WPI-SoftRobotics/SensorModule/TMAG PCB Layout.png

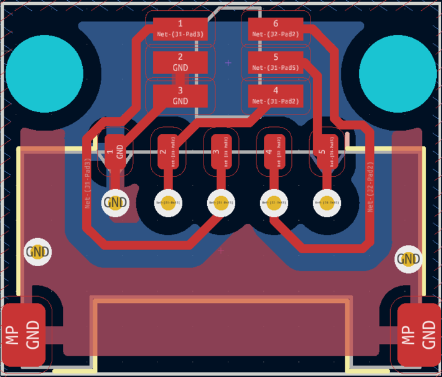
TMAG PCB Layout.png
