WPI-SoftRobotics/SensorModule/README.md

# SensorModule

this is the link to the google drive folder that contains that processed data papers and everything: https://drive.google.com/drive/folders/11iSitZ-SPJbaopdywDdSpedRKp8ysFOF?usp=share_link
