WPI-SoftRobotics/SensorModule/Past Iterations/Sensor/Sensor/TMAG Assembly.SLDASM

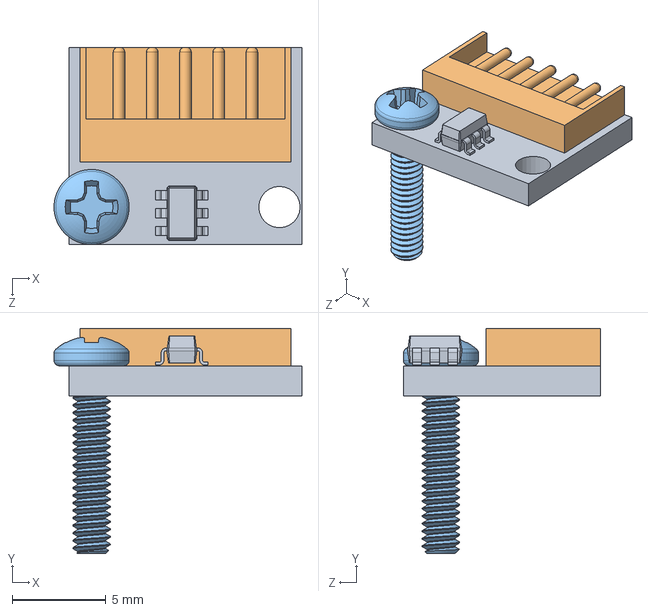
[picture p19: CAD file, 2023-05-02]
Past Iterations/Sensor/Sensor/TMAG Assembly.SLDASM
13.2 x 12.0 x 10.5 mm
