WPI-SoftRobotics/SensorModule/Past Iterations/Sensor/Sensor/Sensor Mount.SLDASM

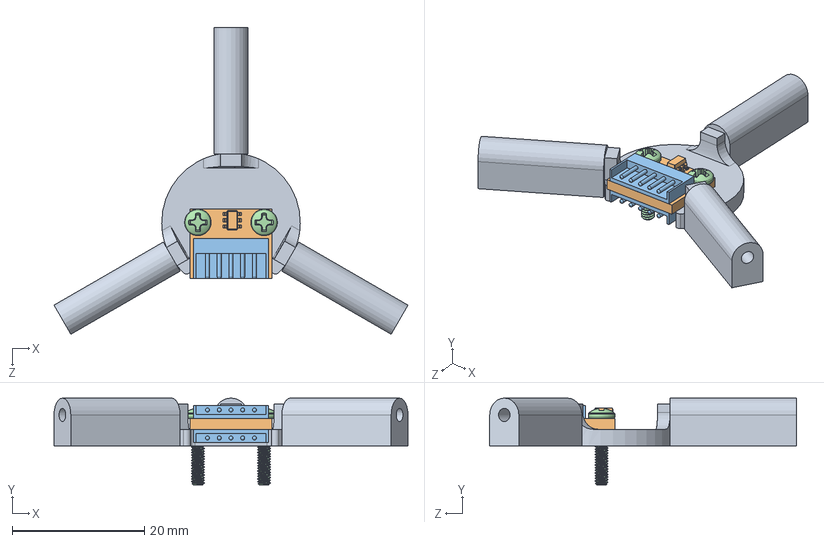
[picture p20: CAD file, 2023-05-02]
Past Iterations/Sensor/Sensor/Sensor Mount.SLDASM
53.4 x 13.1 x 46.3 mm
Sensor Mount
New TMAG5273
Pico Module x 2
96741A017_Brass Pan Head Phillips Screws x 2
