WPI-SoftRobotics/SensorModule/Past Iterations/Sensor testing/SensorTestRigAssem.SLDASM

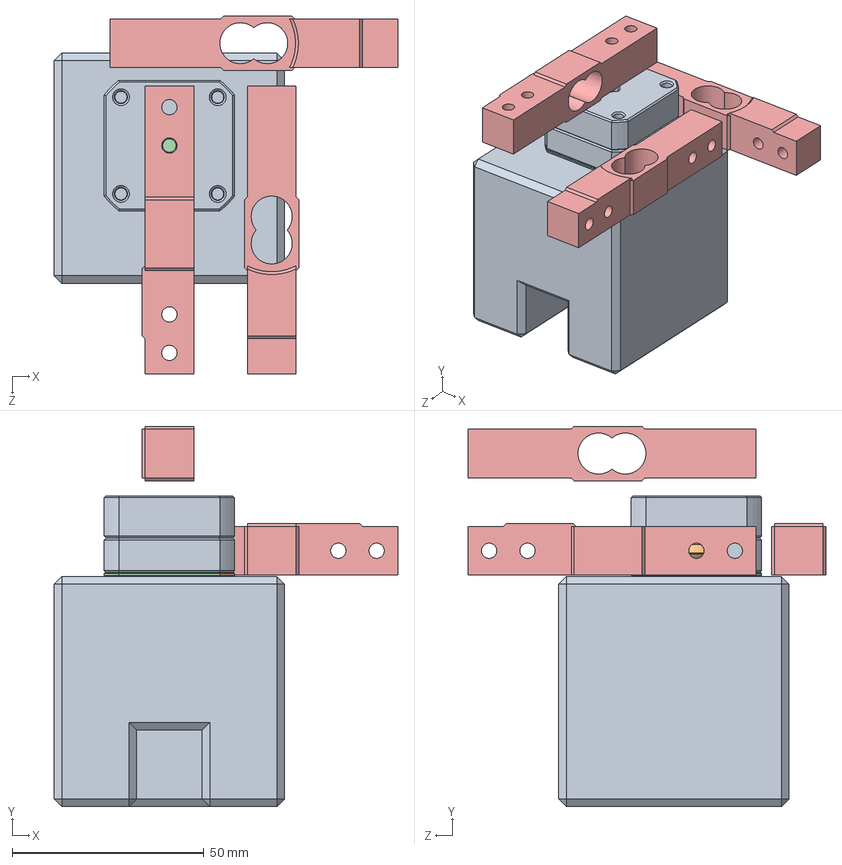
[picture p21: CAD file, 2023-05-02]
Past Iterations/Sensor testing/SensorTestRigAssem.SLDASM
89.5 x 99.1 x 93.2 mm
SensorMount
BellowsV2
ConeV2
FlatV2
LoadCell x 3
Pole
