WPI-SoftRobotics/SensorModule/Past Iterations/Sensor testing/SensorMountTopZ.STL

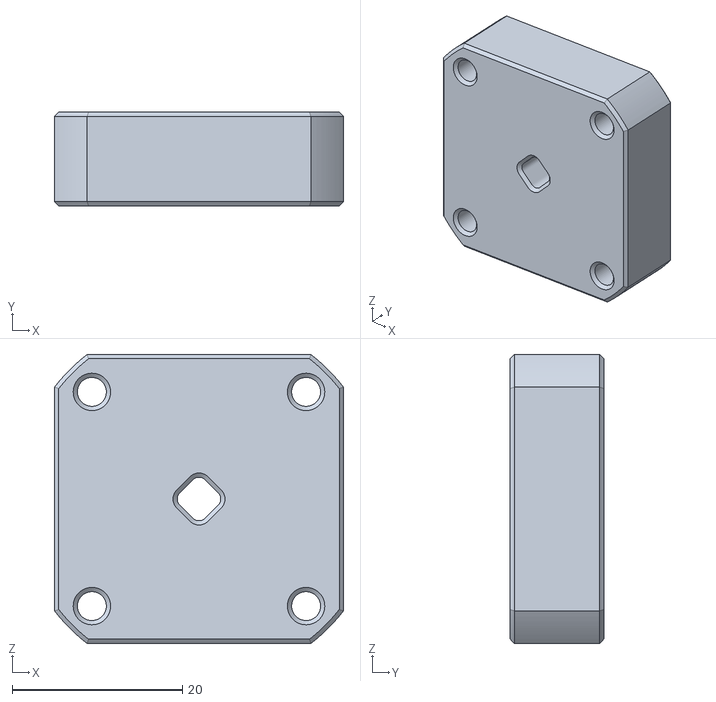
[picture p22: CAD file, 2023-05-02]
Past Iterations/Sensor testing/SensorMountTopZ.STL
34.0 x 11.0 x 34.0
