WPI-SoftRobotics/SensorModule/Past Iterations/Sensor testing/TestAssemSTL/SensorTestRigAssem - FlatBellowsV2-1.STL

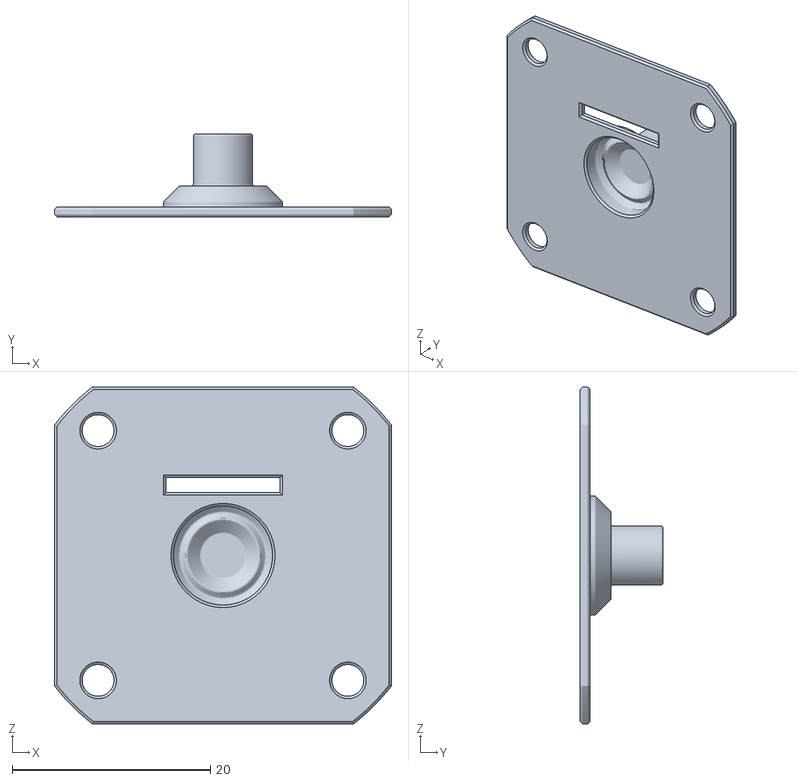
[picture p23: CAD file, 2023-05-02]
Past Iterations/Sensor testing/TestAssemSTL/SensorTestRigAssem - FlatBellowsV2-1.STL
34.0 x 8.35 x 34.0
