WPI-SoftRobotics/SensorModule/Past Iterations/SensorModuleSLA.SLDPRT

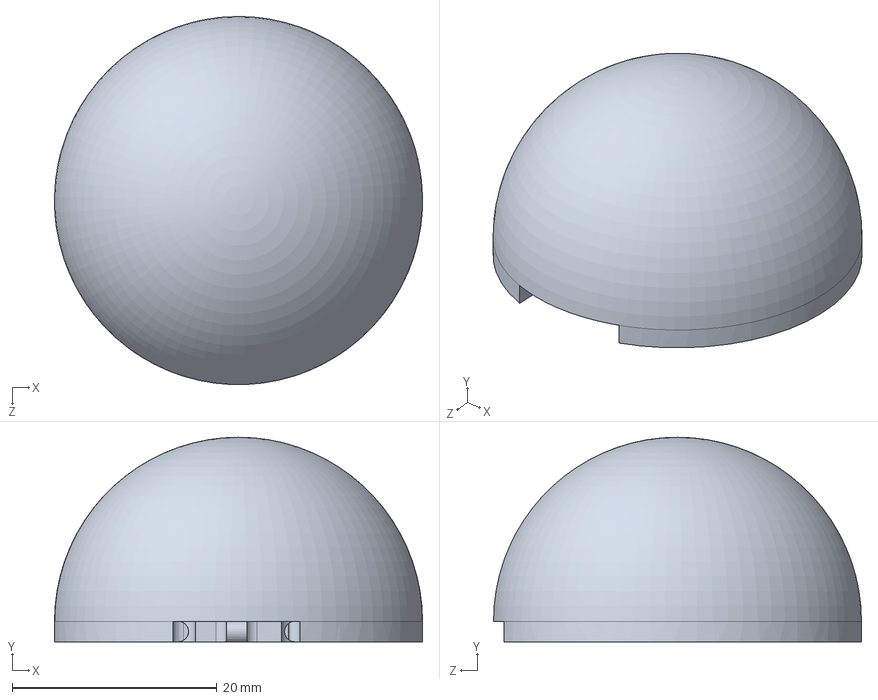
[picture p24: CAD file, 2023-05-02]
Past Iterations/SensorModuleSLA.SLDPRT
36.0 x 20.0 x 36.0 mm
