WPI-SoftRobotics/SensorModule/SensorModuleFDM.STL

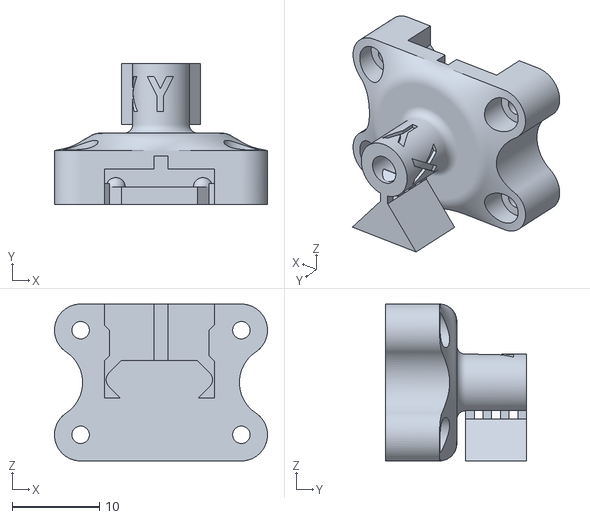
[picture p25: CAD file, 2023-05-02]
SensorModuleFDM.STL
24.4 x 16.2 x 18.0
