WPI-SoftRobotics/SensorModule/Past Iterations/Sensor testing/BellowsFlexture.SLDPRT

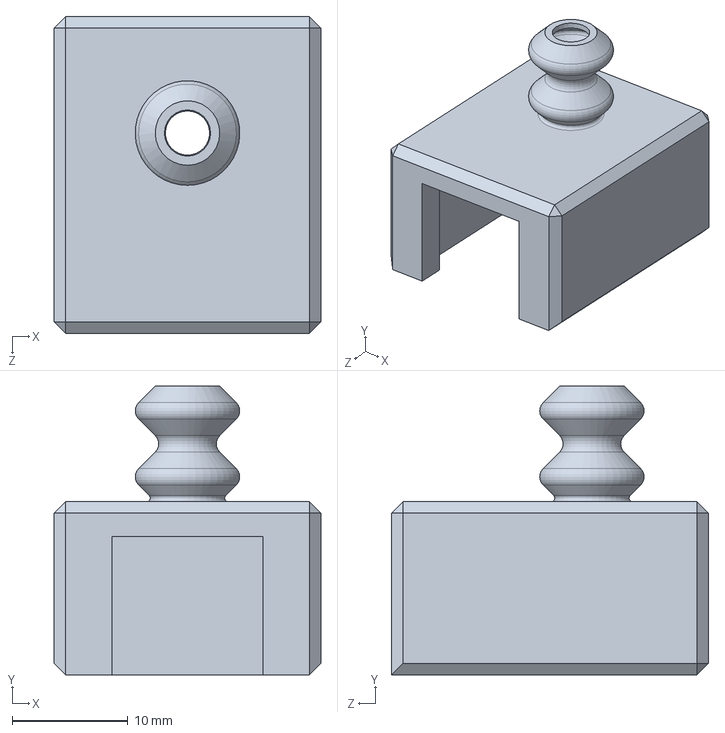
[picture p26: CAD file, 2023-05-02]
Past Iterations/Sensor testing/BellowsFlexture.SLDPRT
23.1 x 25.0 x 27.4 mm
