WPI-SoftRobotics/SensorModule/Past Iterations/Sensor testing/TestAssemSTL/SensorTestRigAssem - Pole-1.STL

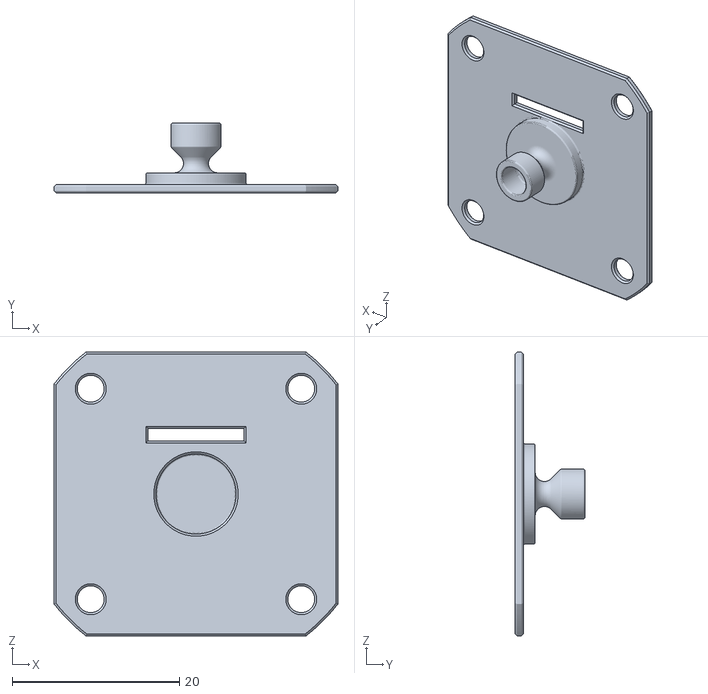
[picture p27: CAD file, 2023-05-02]
Past Iterations/Sensor testing/TestAssemSTL/SensorTestRigAssem - Pole-1.STL
34.0 x 8.35 x 34.0
