WPI-SoftRobotics/SensorModule/Past Iterations/SensorModuleFDM.SLDPRT

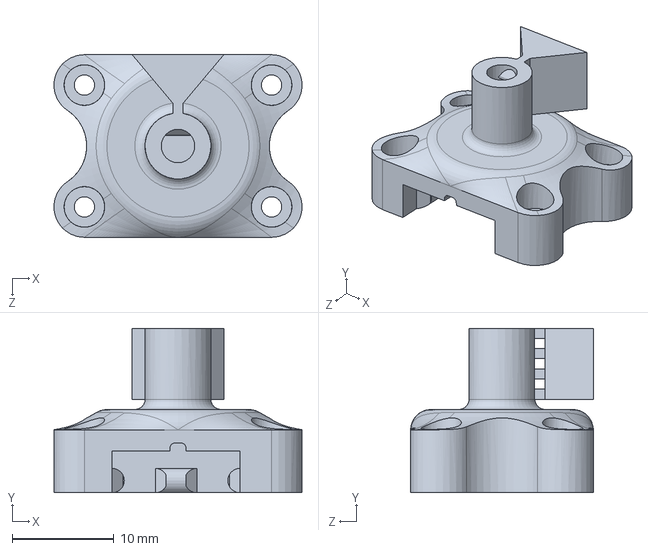
[picture p28: CAD file, 2023-05-02]
Past Iterations/SensorModuleFDM.SLDPRT
24.4 x 16.2 x 18.0 mm
