WPI-SoftRobotics/SensorModule/SensorModuleSLA.STL

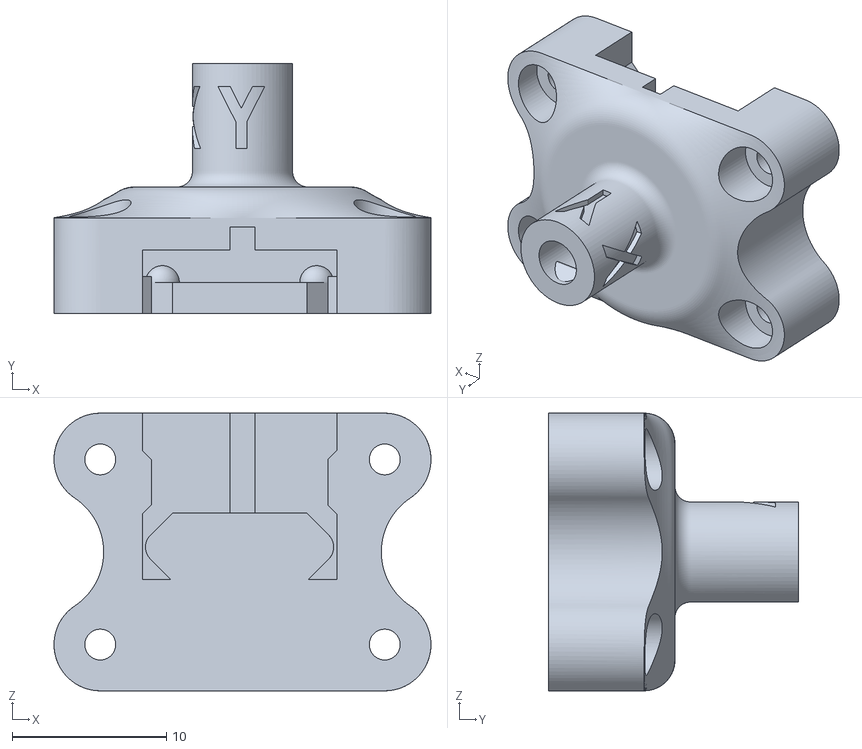
[picture p29: CAD file, 2023-05-02]
SensorModuleSLA.STL
24.4 x 16.2 x 18.0
