WPI-SoftRobotics/SensorModule/Mold_top.STL

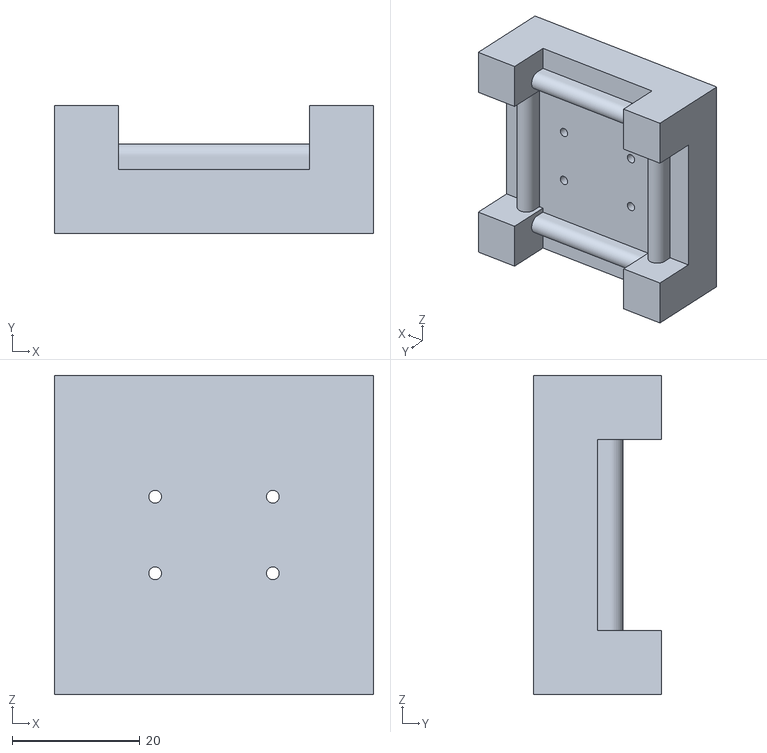
[picture p30: CAD file, 2023-05-02]
Mold_top.STL
50.0 x 20.0 x 50.0
