WPI-SoftRobotics/SensorModule/Past Iterations/Sensor testing/magnet holder medium.STL

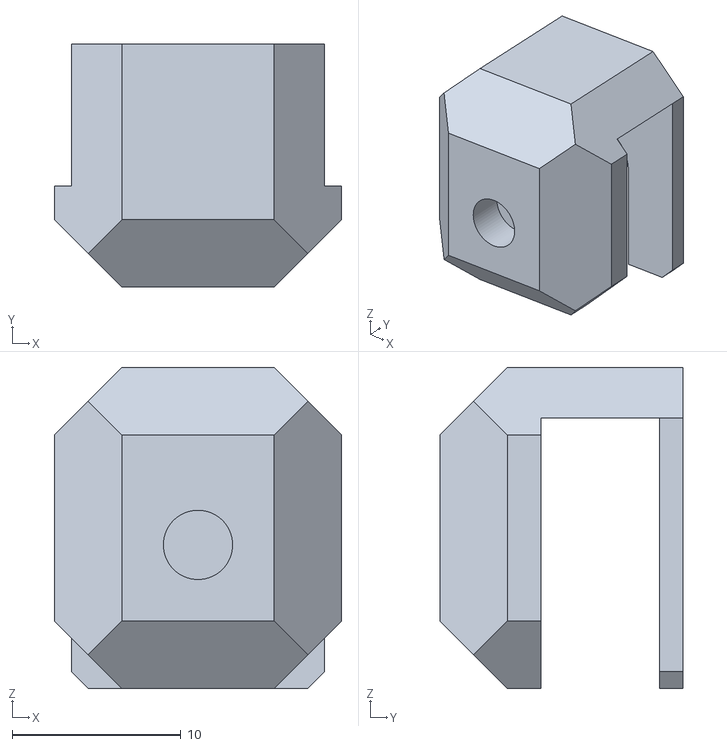
[picture p31: CAD file, 2023-05-02]
Past Iterations/Sensor testing/magnet holder medium.STL
17.0 x 14.4 x 19.0
