WPI-SoftRobotics/SensorModule/Past Iterations/Sensor/Sensor/Motor Mount Test Backplate.SLDPRT

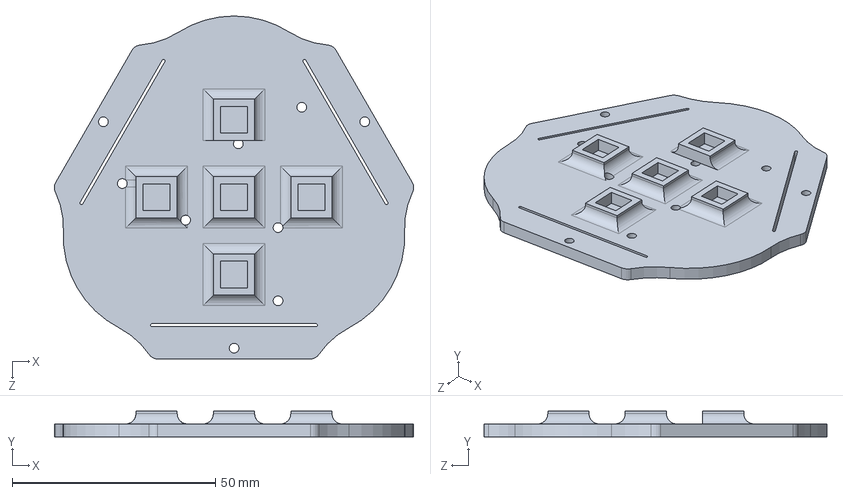
[picture p32: CAD file, 2023-05-02]
Past Iterations/Sensor/Sensor/Motor Mount Test Backplate.SLDPRT
88.4 x 6.35 x 84.4 mm
