WPI-SoftRobotics/SensorModule/Past Iterations/Sensor/Sensor/Motor Mount Backplate.SLDPRT

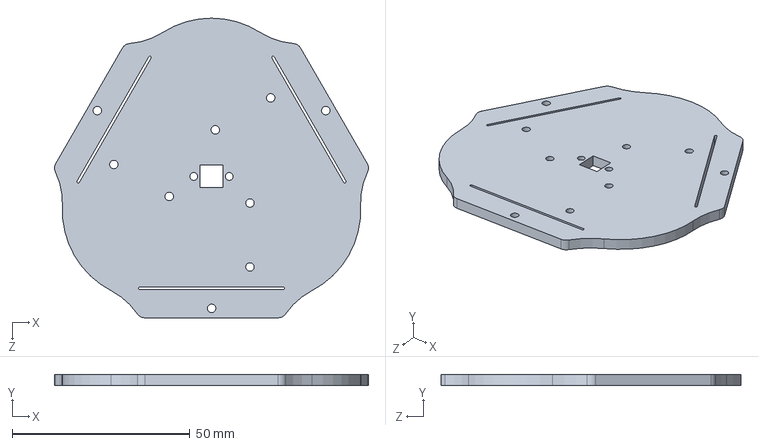
[picture p33: CAD file, 2023-05-02]
Past Iterations/Sensor/Sensor/Motor Mount Backplate.SLDPRT
88.4 x 3.17 x 84.4 mm
