WPI-SoftRobotics/SensorModule/SensorModuleBlank.SLDPRT

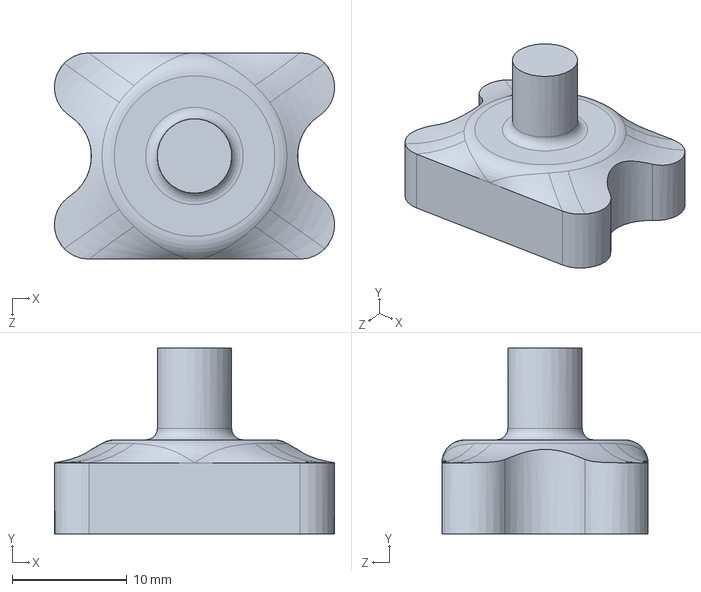
[picture p34: CAD file, 2023-05-02]
SensorModuleBlank.SLDPRT
24.4 x 16.2 x 18.0 mm
