WPI-SoftRobotics/SensorModule/Mold.SLDPRT

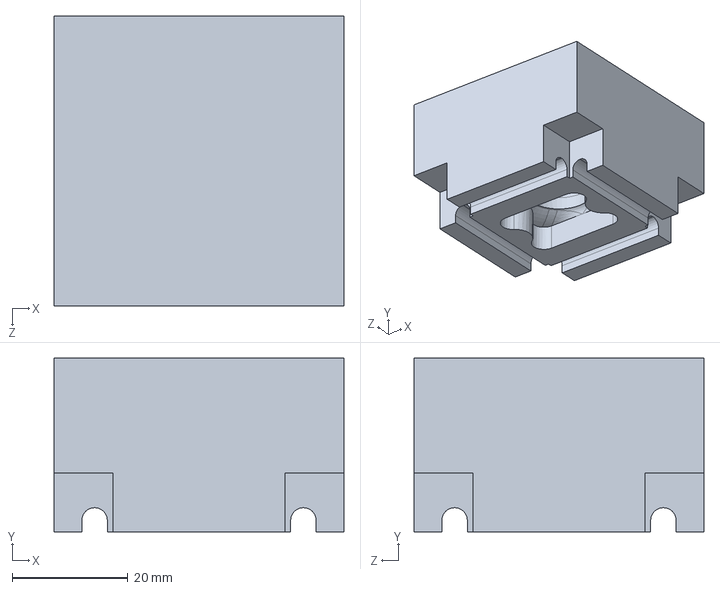
[picture p35: CAD file, 2023-05-02]
Mold.SLDPRT
50.0 x 30.0 x 50.0 mm
