WPI-SoftRobotics/SensorModule/Past Iterations/Sensor/Sensor/Standoff.SLDPRT

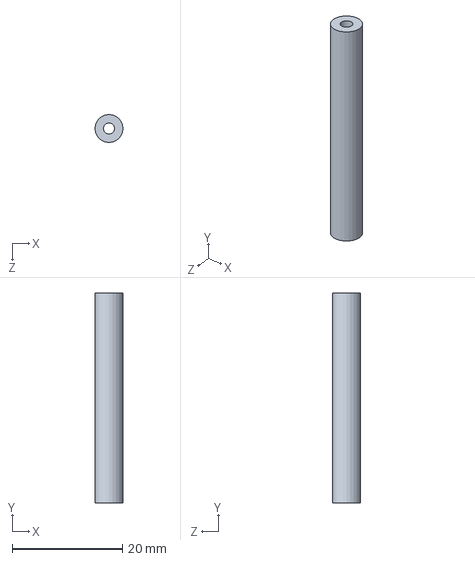
[picture p36: CAD file, 2023-05-02]
Past Iterations/Sensor/Sensor/Standoff.SLDPRT
5.08 x 38.1 x 5.08 mm
