WPI-SoftRobotics/SensorModule/SensorModule.SLDPRT

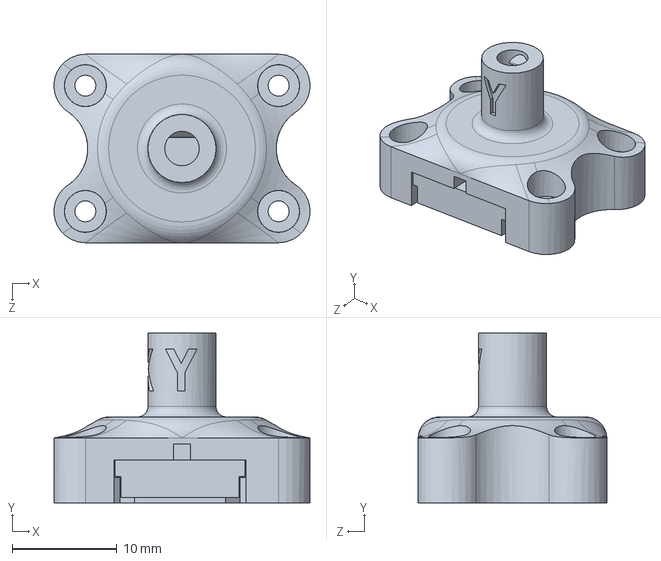
[picture p38: CAD file, 2023-05-02]
SensorModule.SLDPRT
24.4 x 16.2 x 18.0 mm
