WPI-SoftRobotics/SensorModule/Past Iterations/Sensor testing/SensorMountTop.STL

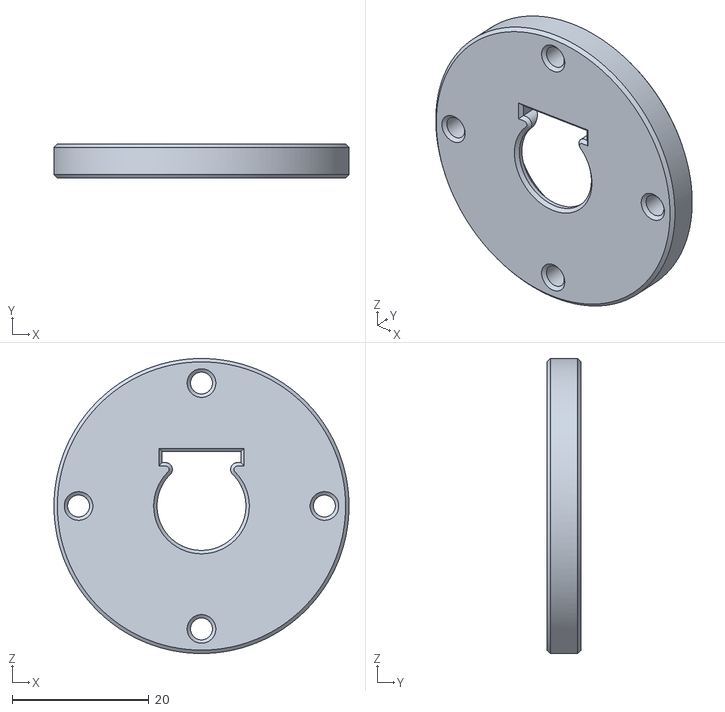
[picture p39: CAD file, 2023-05-02]
Past Iterations/Sensor testing/SensorMountTop.STL
43.2 x 5.00 x 43.2
