WPI-SoftRobotics/SensorModule/Past Iterations/Sensor/Sensor/New TMAG5273.SLDPRT

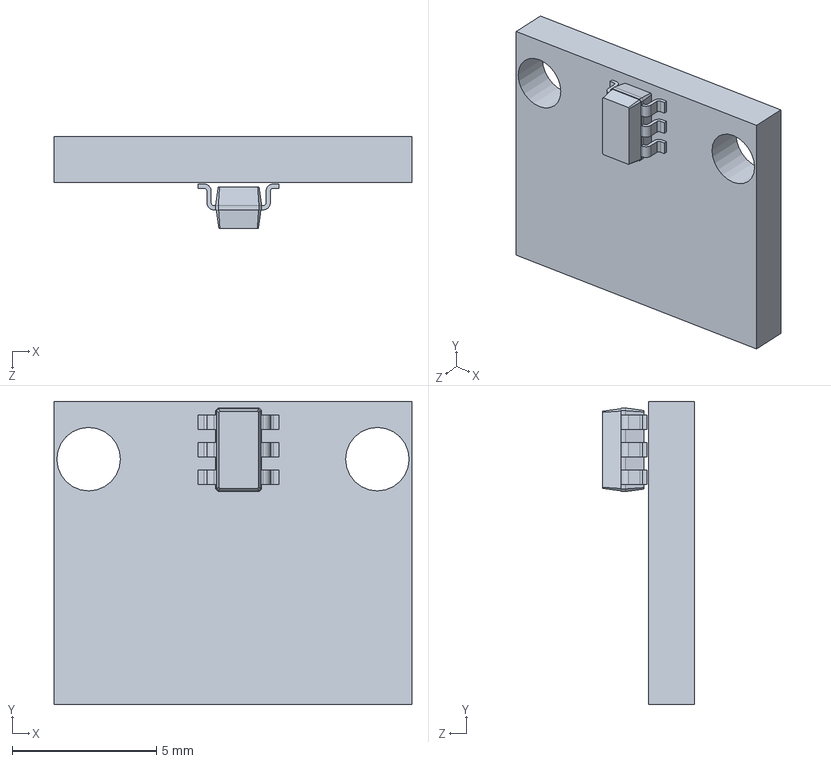
[picture p40: CAD file, 2023-05-02]
Past Iterations/Sensor/Sensor/New TMAG5273.SLDPRT
12.4 x 10.5 x 3.20 mm
