WPI-SoftRobotics/SensorModule/Past Iterations/Sensor/Sensor/Pico Module.SLDPRT

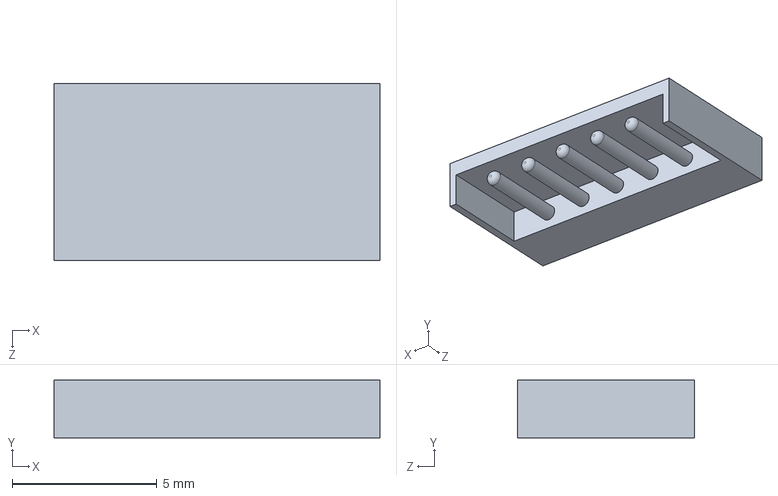
[picture p41: CAD file, 2023-05-02]
Past Iterations/Sensor/Sensor/Pico Module.SLDPRT
11.2 x 2.00 x 6.10 mm
