WPI-SoftRobotics/SensorModule/SensorPCB.SLDPRT

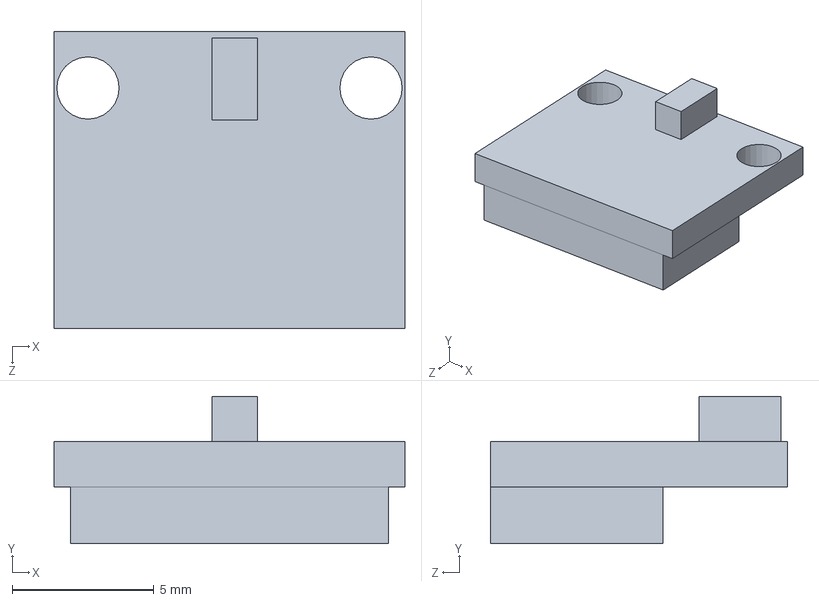
[picture p42: CAD file, 2023-05-02]
SensorPCB.SLDPRT
12.4 x 5.20 x 10.5 mm
