WPI-SoftRobotics/SensorModule/Past Iterations/Sensor testing/BellowsV2.SLDPRT

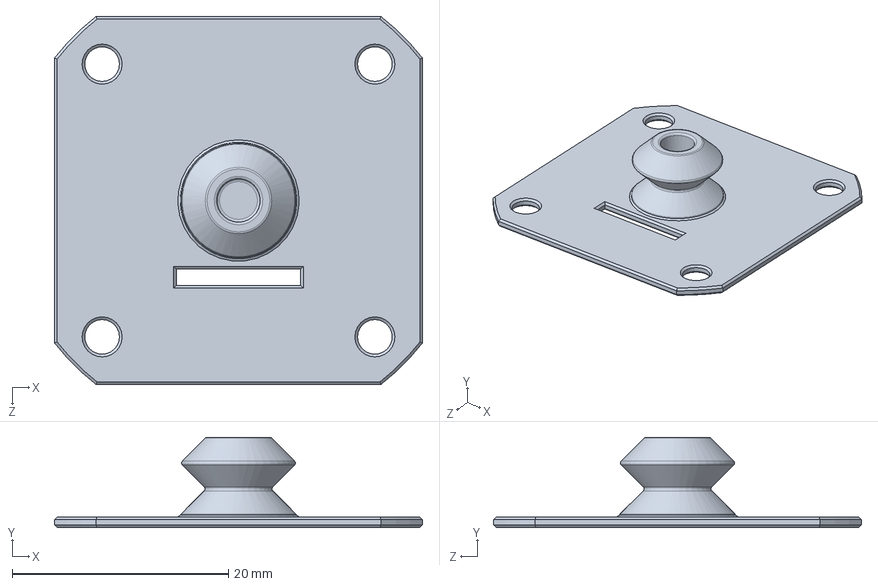
[picture p43: CAD file, 2023-05-02]
Past Iterations/Sensor testing/BellowsV2.SLDPRT
34.0 x 8.35 x 34.0 mm
