WPI-SoftRobotics/SensorModule/Past Iterations/Sensor/Sensor/Magnet Mount.SLDPRT

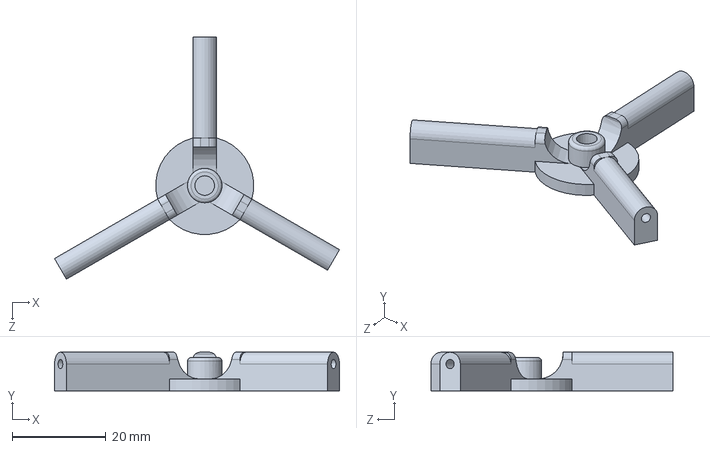
[picture p44: CAD file, 2023-05-02]
Past Iterations/Sensor/Sensor/Magnet Mount.SLDPRT
60.8 x 8.26 x 51.7 mm
