WPI-SoftRobotics/SensorModule/Past Iterations/Sensor testing/LoadCell.SLDPRT

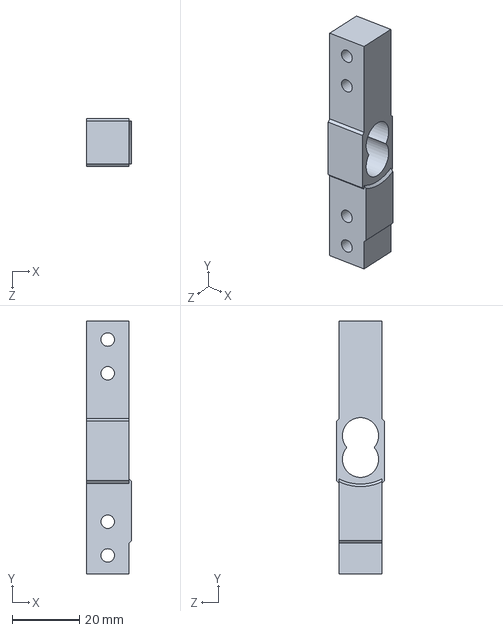
[picture p45: CAD file, 2023-05-02]
Past Iterations/Sensor testing/LoadCell.SLDPRT
13.4 x 75.0 x 14.2 mm
