WPI-SoftRobotics/SensorModule/Past Iterations/Sensor testing/SensorMount.SLDPRT

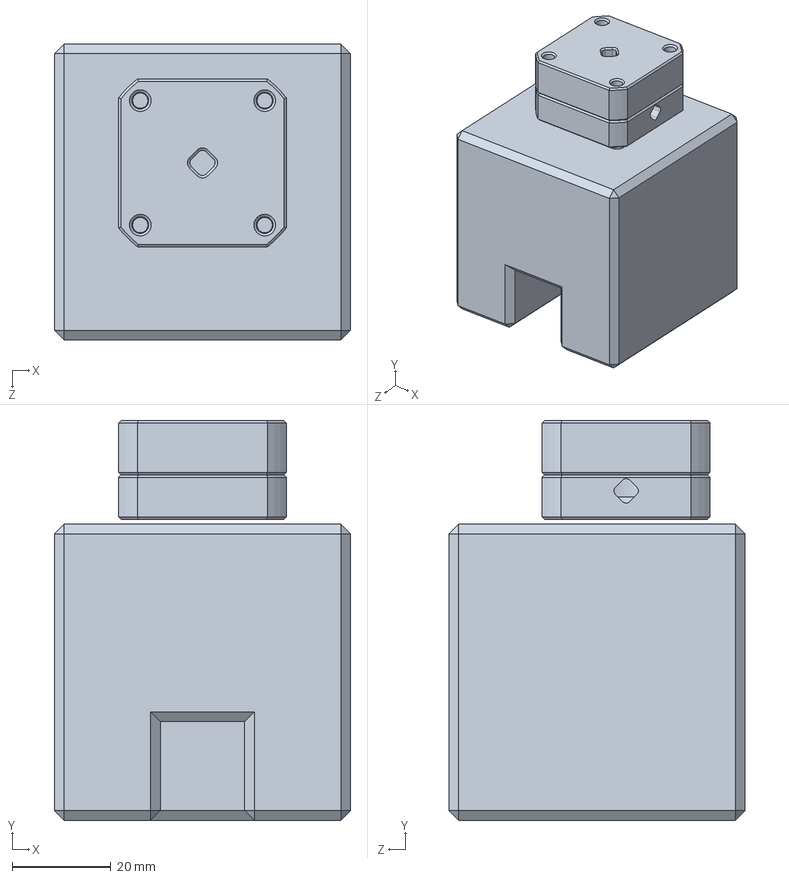
[picture p46: CAD file, 2023-05-02]
Past Iterations/Sensor testing/SensorMount.SLDPRT
60.0 x 81.0 x 60.0 mm
