WPI-SoftRobotics/SensorModule/Past Iterations/Sensor testing/SensorMountBase.3mf

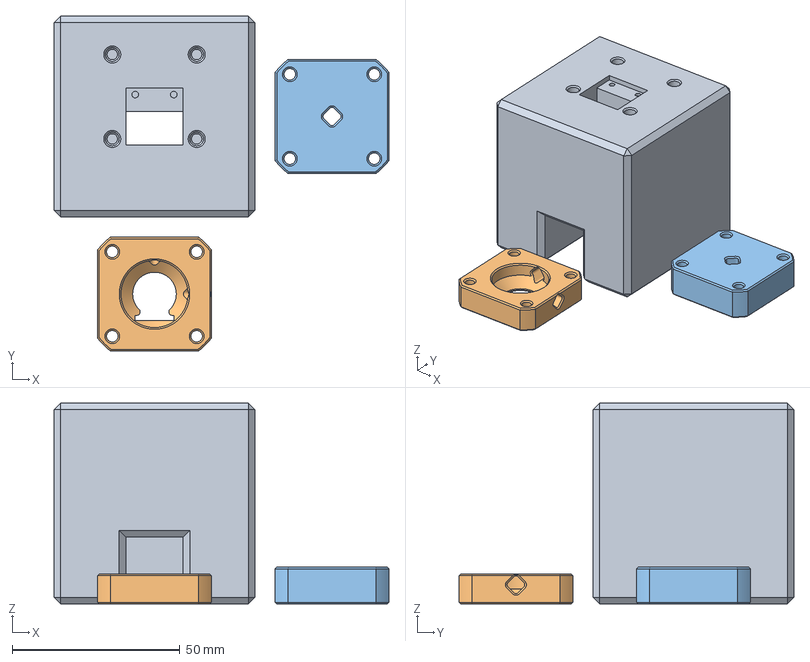
[picture p47: CAD file, 2023-05-02]
Past Iterations/Sensor testing/SensorMountBase.3mf
100.0 x 100.0 x 60.0 mm
SensorMountBase.STL
SensorMountTopXY.STL
SensorMountTopZ.STL
