WPI-SoftRobotics/SensorModule/Past Iterations/Sensor testing/SensorMountTopXY.STL

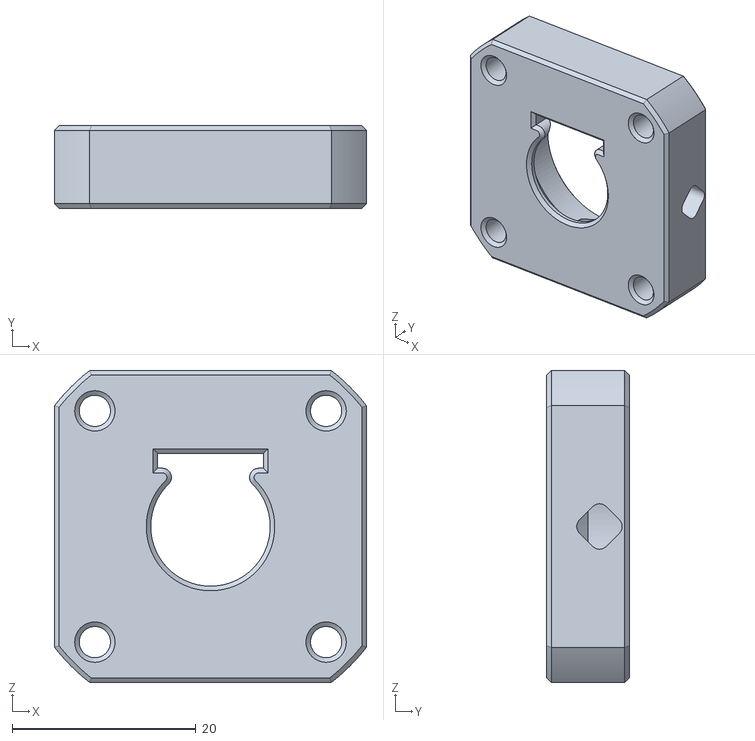
[picture p48: CAD file, 2023-05-02]
Past Iterations/Sensor testing/SensorMountTopXY.STL
34.0 x 9.00 x 34.0
