WPI-SoftRobotics/SensorModule/(list of files, cad)

Other CAD files:
Past Iterations/Sensor testing/TestAssemSTL/SensorTestRigAssem - ConeV2-1.STL
Past Iterations/Sensor testing/TestAssemSTL/SensorTestRigAssem - FlatV2-2.STL
Past Iterations/Sensor testing/Pole.SLDPRT
Mold_bottom.STL
Past Iterations/Sensor testing/ConeV2.SLDPRT
Past Iterations/Sensor testing/magnet holder Small.STL
Past Iterations/Sensor testing/FlatV2.SLDPRT
Past Iterations/Sensor testing/magnet holder.SLDPRT
Past Iterations/Sensor testing/BellowsFlexture.3mf
Past Iterations/Sensor testing/BellowsFlexture.STL
Past Iterations/Sensor testing/SensorMount.STL
Past Iterations/Sensor testing/SensorMountBase.STL
Past Iterations/Sensor/Sensor/96741A017_Brass Pan Head Phillips Screws.SLDPRT
Past Iterations/Sensor/Sensor/Sensor Mount.SLDPRT
