WPI-SoftRobotics/SensorModule/Code/Data/module/testrun.csv

=~=~=~=~=~=~=~=~=~=~=~= PuTTY log 2023.04.20 12:20:11 =~=~=~=~=~=~=~=~=~=~=~=
893 | 165 | -107 | 623 | 0.98
1060 | 161 | -107 | 623 | 1.47
1227 | 164 | -108 | 623 | 1.59
1394 | 164 | -107 | 623 | 1.62
1561 | 167 | -108 | 623 | 1.96
1728 | 161 | -107 | 623 | 2.14
1895 | 162 | -106 | 623 | 1.91
2062 | 160 | -106 | 622 | 1.98
2229 | 161 | -107 | 622 | 2.22
2396 | 161 | -106 | 622 | 2.63
2563 | 164 | -106 | 623 | 2.64
2728 | 163 | -107 | 623 | 3.04
2895 | 164 | -108 | 623 | 3.17
3062 | 167 | -107 | 624 | 3.41
3229 | 169 | -108 | 624 | 3.46
3396 | 170 | -108 | 625 | 3.73
3563 | 168 | -108 | 625 | 3.88
3730 | 172 | -109 | 625 | 3.91
3897 | 173 | -109 | 625 | 4.37
4064 | 171 | -108 | 625 | 4.65
4231 | 177 | -108 | 626 | 19.64
4398 | 191 | -108 | 625 | 69.26
4564 | 193 | -108 | 624 | 92.22
4731 | 200 | -108 | 624 | 112.50
4898 | 224 | -109 | 628 | 141.88
5065 | 275 | -112 | 637 | 263.37
5232 | 310 | -110 | 645 | 497.67
5399 | 345 | -110 | 655 | 624.04
5566 | 385 | -111 | 667 | 748.41
5733 | 421 | -112 | 677 | 870.81
5900 | 451 | -113 | 685 | 963.18
6067 | 416 | -112 | 678 | 996.27
6234 | 306 | -110 | 655 | 653.43
6401 | 255 | -108 | 645 | 438.01
6567 | 233 | -106 | 641 | 268.95
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
